simon-cunningham/Environmental_monitor/README.md

# Environmental_monitor
Arduino environmental monitor
