simon-cunningham/Environmental_monitor/3D_Printing/etherTen_case.stl

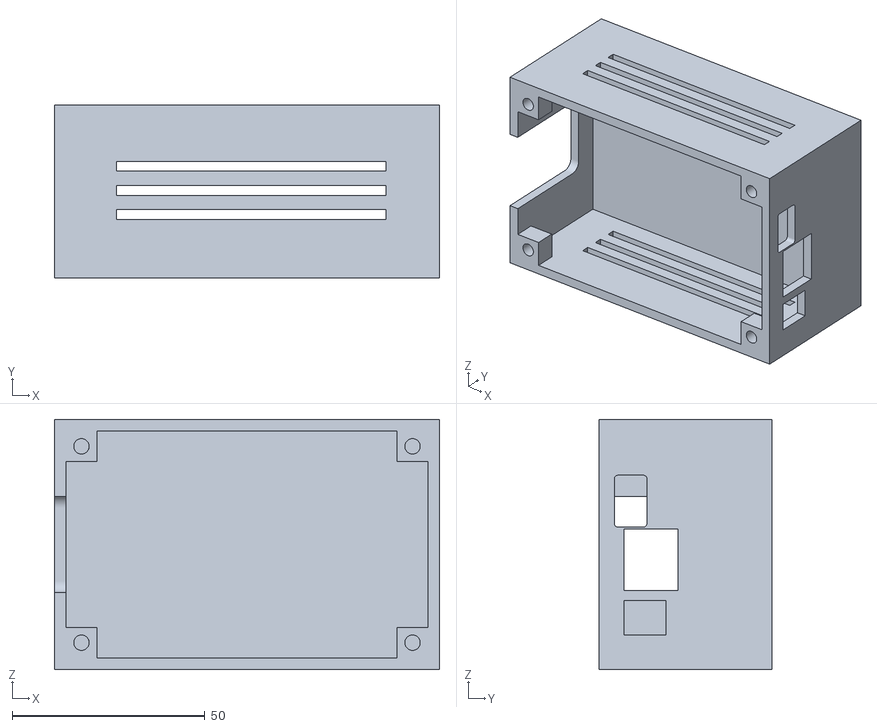
[picture p8: CAD file, 2018-07-04]
3D_Printing/etherTen_case.stl
100.0 x 45.0 x 65.0
