simon-cunningham/Environmental_monitor/3D_Printing/Sensor_Case.stl

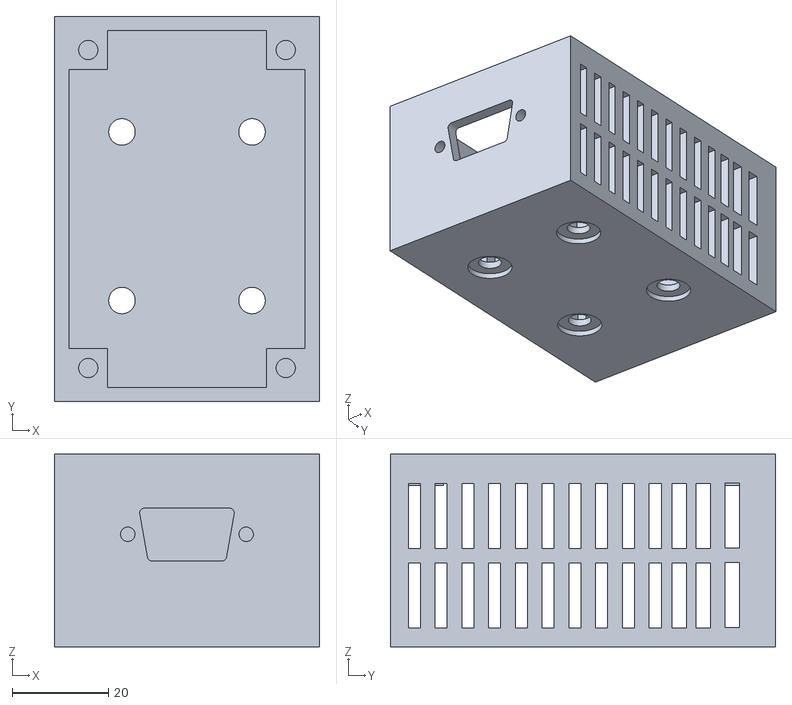
[picture p9: CAD file, 2018-07-04]
3D_Printing/Sensor_Case.stl
55.0 x 80.0 x 40.0
