simon-cunningham/Environmental_monitor/3D_Printing/etherTen_base.stl

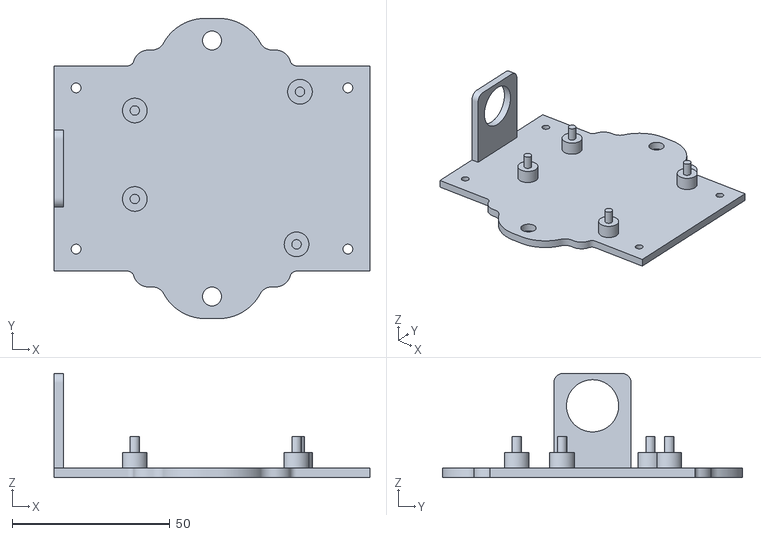
[picture p10: CAD file, 2018-07-04]
3D_Printing/etherTen_base.stl
100.0 x 95.0 x 33.0
