simon-cunningham/Environmental_monitor/3D_Printing/Sensor_Base.stl

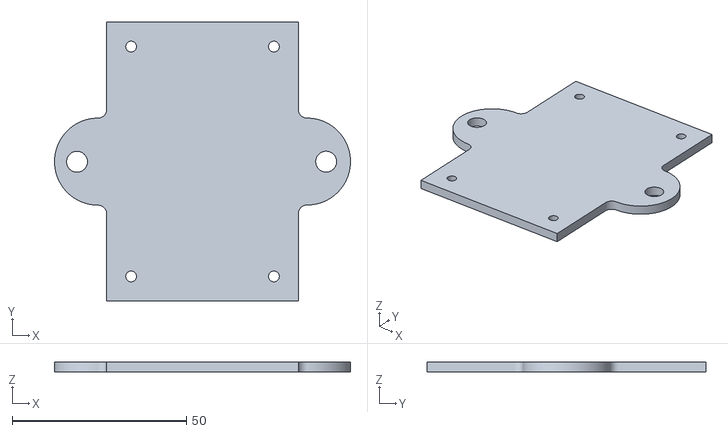
[picture p11: CAD file, 2018-07-04]
3D_Printing/Sensor_Base.stl
85.0 x 80.0 x 3.00
